SunbirdAI/Sunbird-Acoustic-Environmental-Sensor/hardware/sunbird-enclosure.SLDASM

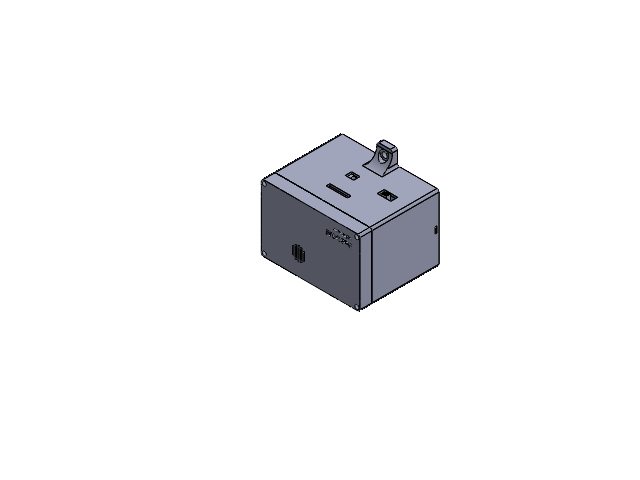
[picture p1: CAD file, 2026-02-02]
hardware/sunbird-enclosure.SLDASM
18650-2PIN-BOX.stp
PCB_1.stp
PCB_2.stp
PCB_3.stp
PCB_4.stp
PCB_5.stp
PCB_6.stp
PCB_7.stp
PCB_8.stp
PCB_9.stp
PCB_10.stp
PCB_11.stp
PCB_12.stp
PCB_13.stp
PCB_14.stp
PCB_15.stp
PCB_16.stp
PCB_17.stp
PCB_18.stp
PCB_19.stp
PCB_20.stp
PCB_21.stp
PCB_22.stp
PCB_23.stp
PCB_24.stp
PCB_25.stp
PCB_26.stp
PCB_27.stp
PCB_28.stp
PCB_29.stp
PCB_30.stp
PCB_31.stp
PCB_32.stp
PCB_33.stp
PCB_34.stp
PCB_35.stp
PCB_36.stp
PCB_37.stp
PCB_38.stp
PCB_39.stp
PCB_40.stp
PCB_41.stp
PCB_42.stp
PCB_43.stp
PCB_44.stp
PCB_45.stp
PCB_46.stp
PCB_47.stp
PCB_48.stp
PCB_49.stp
PCB_50.stp
PCB_51.stp
PCB_52.stp
PCB_53.stp
PCB_54.stp
PCB_55.stp
PCB_56.stp
PCB_57.stp
PCB_58.stp
PCB_59.stp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
