SunbirdAI/Sunbird-Acoustic-Environmental-Sensor/hardware/seas-sensor-hat-pcb.pdf

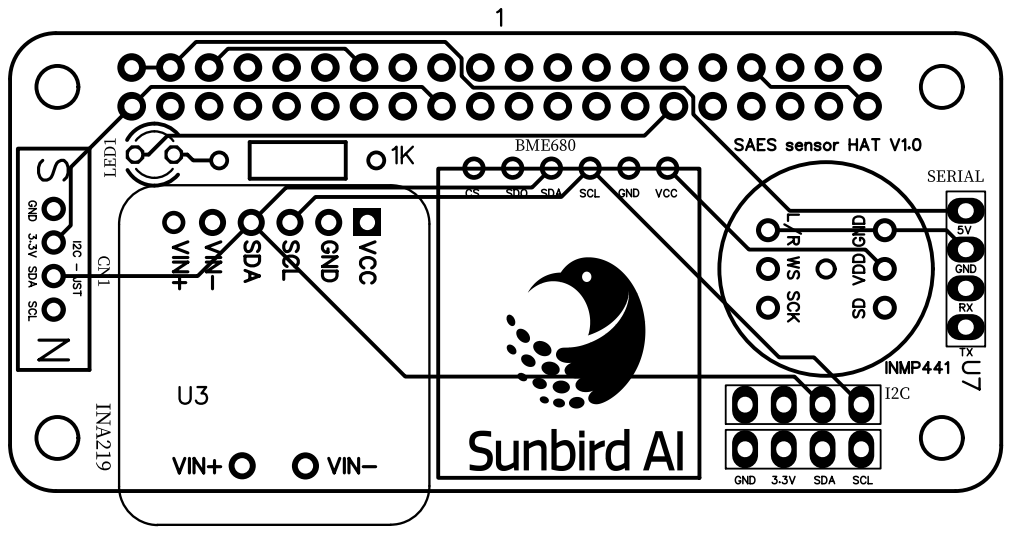
[picture p2: page 1]
