SunbirdAI/Sunbird-Acoustic-Environmental-Sensor/hardware/seas-sensor-hat-schematic.pdf

A | A

1

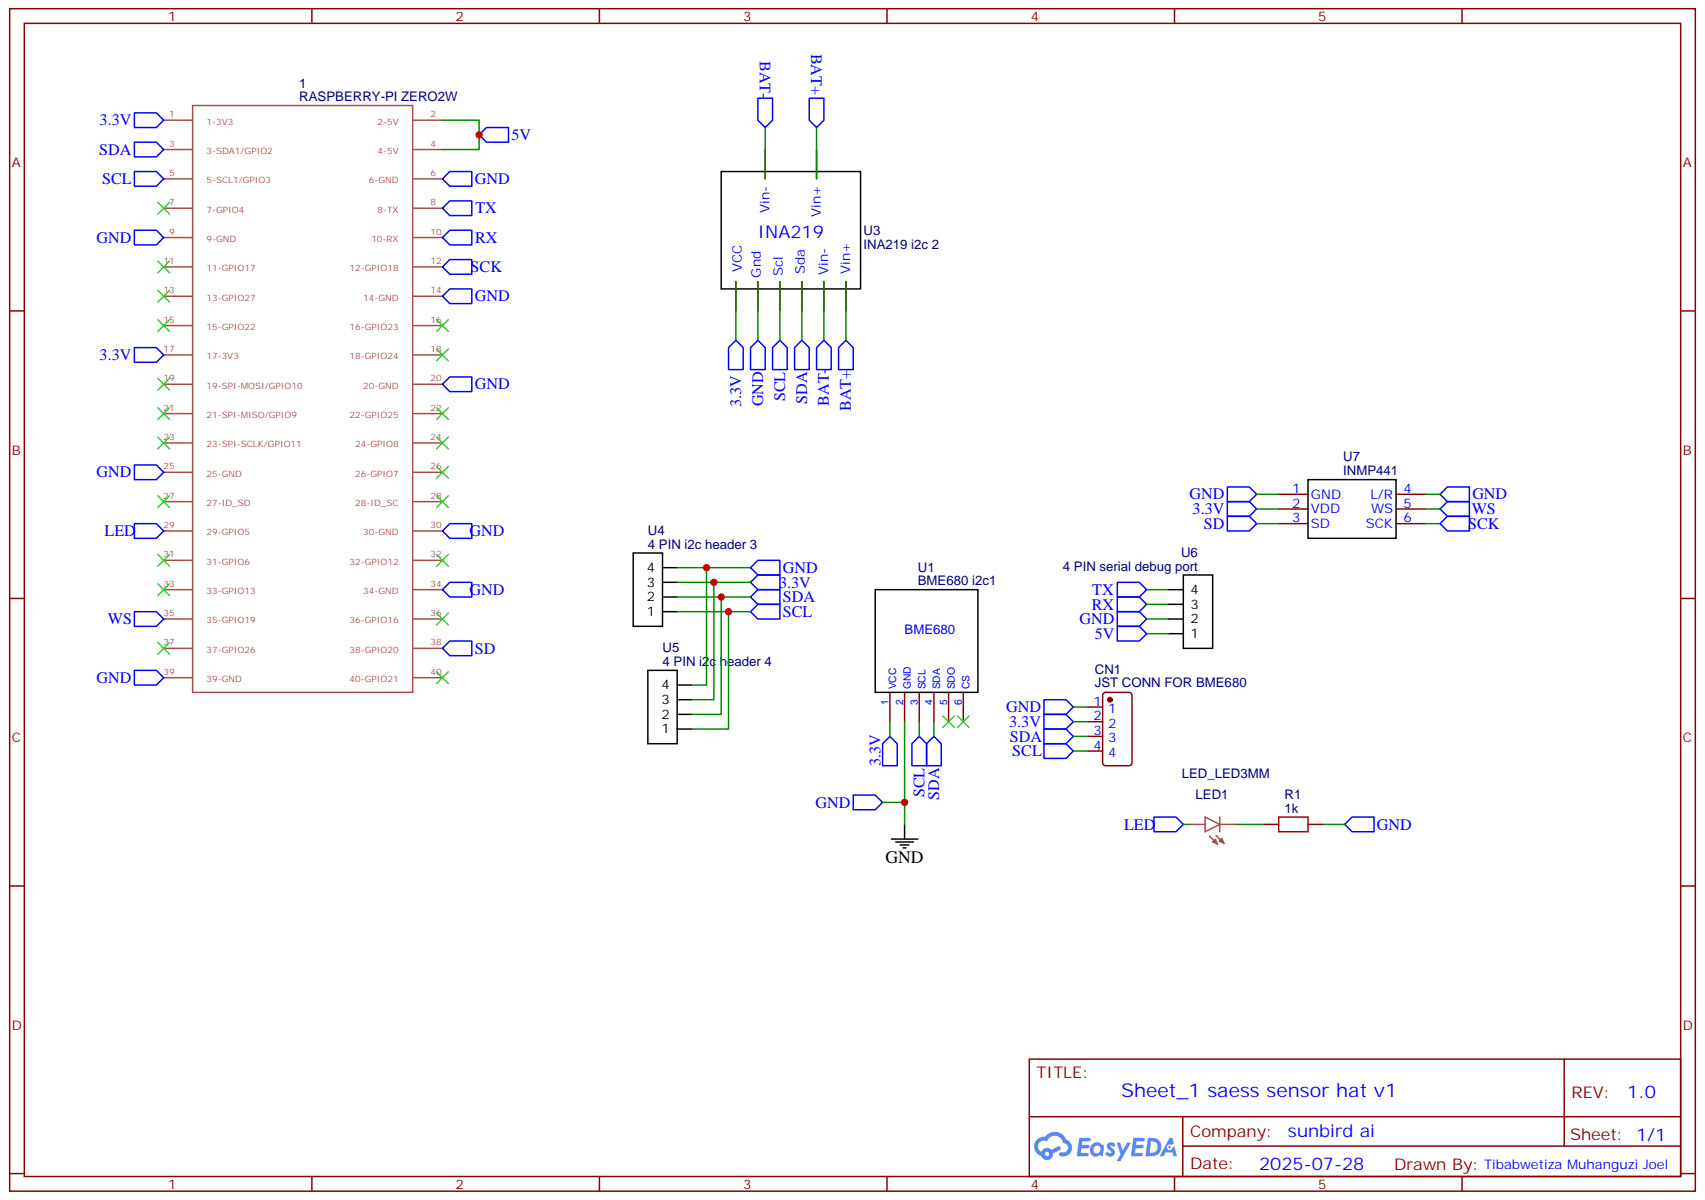
[picture p3: page 1]
