SunbirdAI/Sunbird-Acoustic-Environmental-Sensor/(commit log)

2025-06-16 Create metadatalogger.py
    script to log meta data from the sensor
2025-06-27 Add files via upload
    Updated Logging Code and Inference code but inference code under review, worked prioer to deployment but currently acting funny in the field
2026-02-02 schematic files, seas sensor
    [PCB_PCB_seas-sensor-hat_2026-02-02.json]
2026-02-02 3D design file
    [sunbird enclosure.SLDASM]
2026-08-07 Set DEVICE_ID to SEAS-3
2026-10-14 Add rain-sensor package; fix INMP441 spelling in README
2026-11-06 Sync repo with deployed SEAS-2 unit; YAMNet+TRILL model, dB(A) logging
    inference.py
    - DEVICE_ID SEAS-2, endpoints on noise-api.sunbird.ai
    - Use the combined YAMNet+TRILL model (seas_noise_classifier_v3.tflite);
    v2 (YAMNet only) kept as a lighter fallback
    - Record 4 s, classify, upload class/probability only; audio upload off
    (UPLOAD_AUDIO=False) and clips always deleted, for privacy
    - Model outputs probabilities already, so no extra softmax; 19 labels in
    the model's alphabetical order
    - Run every 60 s, matching the environmental logger
    modifiedlogger.py
    - Take the deployed copy (noise-api endpoint, SEAS-2)
    - db_level is now LAeq in dB(A) (A-weighted, energy averaged), recorded from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
    [inference.py, modifiedlogger.py]
2026-11-06 Rename scripts and services for consistency
    Scripts: inference.py -> noise_inference.py, modifiedlogger.py ->
    env_logger.py, batterymetricsv2.py -> battery_monitor.py. Older variants
    (metadatalogger.py, record-infer-pushtoserver.py) moved to legacy/.
    Services (installer and README) now match the scripts:
    seas-noise-inference, seas-env-logger, seas-battery-monitor. The SEAS-2 unit
    runs seas-noise-inference and seas-env-logger.
    Also: ignore __pycache__/*.pyc and drop the committed rain-sensor .pyc.
    [battery_monitor.py, env_logger.py, metadatalogger.py, noise_inference.py, record-infer-pushtoserver.py]
2026-11-09 Reorganise repo and make installation one command
    - Move scripts to pi/, models to models/ (older ones in models/archive/),
    schematics to hardware/
    - Rewrite install.sh to match the working unit: system Python, restart-always
    services, 512 MB swap, ALSA devices, per-device settings in /etc/seas/seas.env
    - Device ID and calibration offset now come from the environment
    - Shorten README; move detail to docs/ (wiring, manual install, calibration,
    data format, troubleshooting)
    - Cross-link the Gen-2 urban-noise-sensor repository
    [sunbird-enclosure.SLDASM]
2026-11-09 Rename project to Sunbird Environmental Acoustic Sensor (SEAS)
    Matches the acronym; repository is now SunbirdAI/seas. Update the install
    URL and names in docs and scripts.
